tuppi-ovh/data-server-vmc/README.md

# Data Server VMC

## Documentation

Refer to [docs/doc_data_server_vmc.md](docs/doc_data_server_vmc.md) file.

## License

Refer to [LICENSE](LICENSE) file.
