tuppi-ovh/data-server-vmc/docs/sources/doc-hardware-design.odp

## Continuous Mandatory Ventilation Controller

Project 2019

## Deep Sleep Mode

2019-03-22 21:54

uC active : > 30 mA

Deep sleep : 5.7 mA

Deep sleep w/o sensor : 5.7 mA

Deep sleep w/o sensor & RF : 4.5 mA

Quiescent

Current 5 mA!

pin | description
1 | NC
2 | GPIO16
3 | RST

Deep sleep

mode activated

## User LED

1.9V

ESP8266

GPIO5

5V

## RF433 Connector

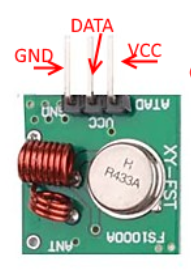
[picture p3: figure]
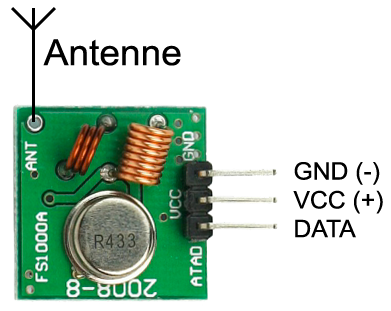
[picture p4: figure]

pin | description
1 | 5V
2 | key
3 | NC
4 | GPIO14 (data)
5 | GND

Board

RF433

## DHT22 Connector

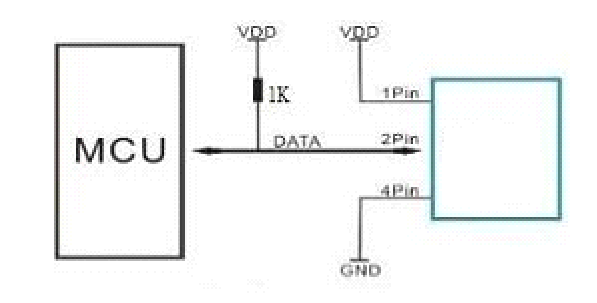
[picture p5: figure]
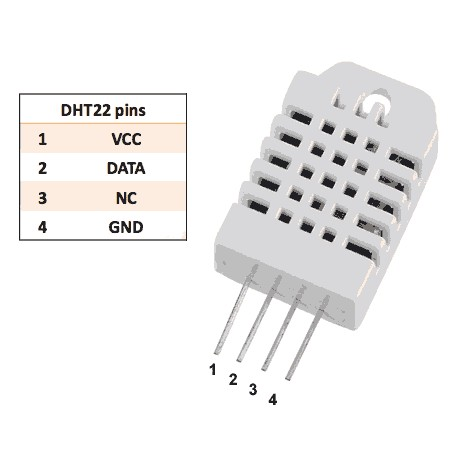
[picture p6: figure]

pin | description
1 | 3.3V
2 | GPIO12
3 | key
4 | key
5 | GND

Board

Sensor

DHT22

## Electrical Connection

N

N

220V

220V

CMV Controller

433 MHz

433 MHz

Interruptor

CMV Motor

Triple

Interruptor

DIO

++++

++

Neutral

## Annex. ESP8266 pinout

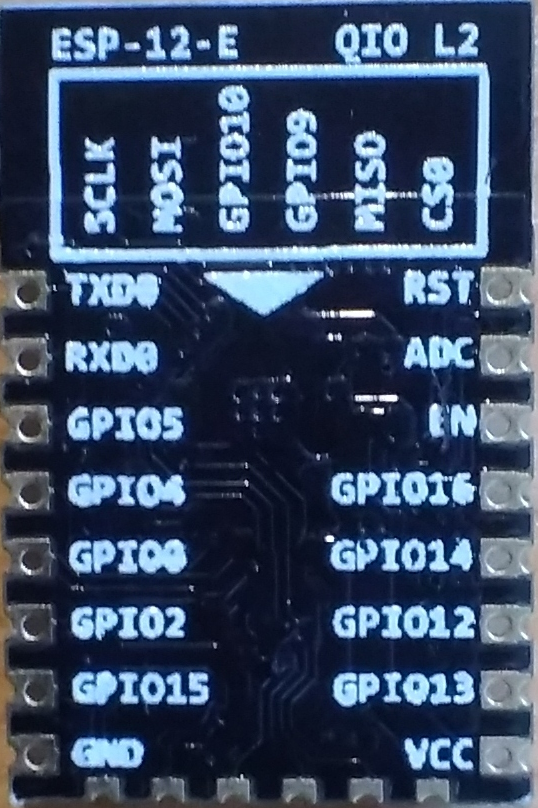
[picture p7: figure]
