tuppi-ovh/data-server-vmc/docs/sources/img_433mhz_tx.png

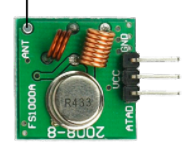
docs/sources/img_433mhz_tx.png
