tuppi-ovh/data-server-vmc/docs/sources/img_connector_7p.png

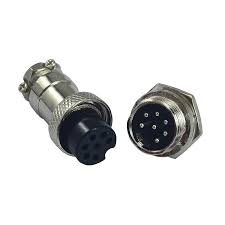
docs/sources/img_connector_7p.png
