tuppi-ovh/data-server-vmc/docs/sources/img_esp8266.png

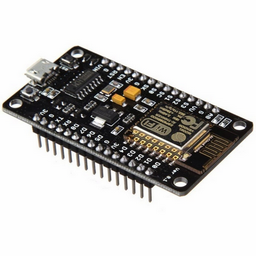
docs/sources/img_esp8266.png
