tuppi-ovh/data-server-vmc/(list of files, drawings)

Other design files:
pcb/design_v1.pcb
pcb/design_v2.pcb
