tuppi-ovh/data-server-vmc/(commit log)

2020-05-07 add docs folder & finilize new sensor integration
2021-05-20 Update config doc and arduino dependencies installation
2021-05-22 make vmc hardware open source
    [design_v1.pcb, design_v2.pcb]
2021-05-23 Fix bug with force update & http errors print
    [sketch.ino]
